gpt-lab-summer-2026/rc-tank/raw.png

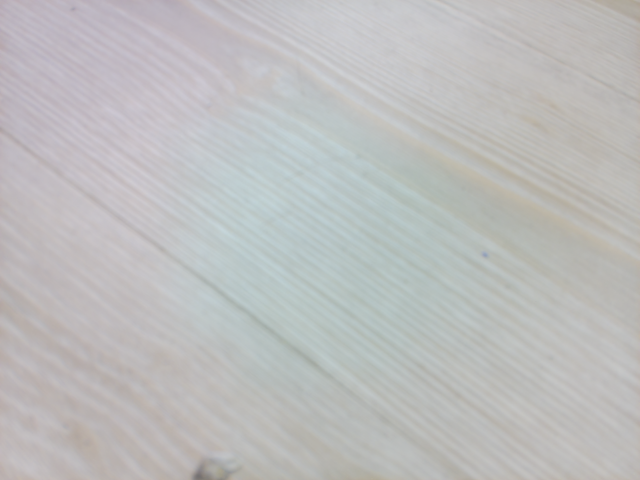
raw.png
