gpt-lab-summer-2026/rc-tank/roam.jpg

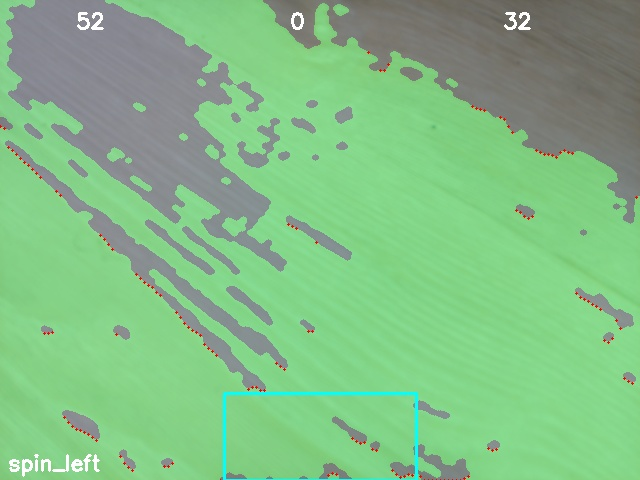
roam.jpg
