gpt-lab-summer-2026/rc-tank/esp32_relay_bridge/esp32_relay_bridge.ino

/* =============================================================
   ESP32 relay bridge — serial in, relays out
   -------------------------------------------------------------
   The Pi decides everything. This firmware holds no idea of what
   forward means, how a turn should look, or how long to hold it.
   It sets relay states and reports back.

   Flash it once. All driving logic lives in Python.

   -------------------------------------------------------------
   WIRING

     ESP32 GPIO 27 -> IN1     motor 1, relay A
     ESP32 GPIO 26 -> IN2     motor 1, relay B
     ESP32 GPIO 25 -> IN3     motor 2, relay A
     ESP32 GPIO 33 -> IN4     motor 2, relay B
     ESP32 GND     -> module GND
     module VCC    -> 5V

     ESP32 GPIO 32 -> buzzer +
     ESP32 GND     -> buzzer -

     ESP32 GPIO 13 -> camera mast servo signal
     servo V+      -> 5V        (see the current note below)
     servo GND     -> common GND

     COM -> its own motor terminal
     NO  -> battery +    (all four)
     NC  -> battery -    (all four)

   -------------------------------------------------------------
   BUZZER — NOT ON GPIO 35

   GPIO 34, 35, 36 and 39 on a classic ESP32 are input-only. They
   have no output driver on the die at all, so pinMode(OUTPUT) is
   ignored and the pin can neither source nor sink current. A buzzer
   wired to one of them is silent no matter what this firmware does,
   and nothing reports an error. GPIO 32 is used instead: free here,
   not a strapping pin, and next to 33 on most dev boards.

   It wants a PASSIVE buzzer — the kind with no oscillator inside.
   Those take a square wave and play whatever pitch you feed them,
   which is what makes three distinct notes possible. An ACTIVE
   buzzer has its own oscillator and one fixed pitch, so the tune
   below degenerates into three beeps of the same note. Still a
   usable startup signal, just not a tune.

   A piezo element can hang straight off the GPIO — it is basically
   a capacitor and draws almost nothing. An electromagnetic buzzer
   cannot: it will pull more than the 20 mA a pin should give, so
   drive it through a small NPN transistor with a flyback diode, and
   take the coil current from 5V rather than 3V3. That rail is
   already the one that browns out under motor inrush.

   On this build motor 1 (IN1/IN2) is the RIGHT track and motor 2
   (IN3/IN4) is the LEFT. The firmware neither knows nor cares —
   car.py hands the sides over to match. See SWAP_SIDES there.

   Pi connects over USB. 115200 baud.

   TWO RULES THAT KEEP A DEAD ESP32 FROM DRIVING THE MOTORS

   1. FIT A 10k PULL-UP FROM EACH OF IN1..IN4 TO 3V3.

      Between the moment this chip resets and the first line of
      setup() below, its pins are floating inputs. On an active-low
      board a floating input can read as "on", holding the relays
      closed while no code is running to release them. Firmware
      cannot close that window — only the pull-ups can.

   2. KEEP THE COILS ON THE SAME 5V AS THIS CHIP.

      Tempting to give the coils their own supply, since their
      switching noise is what sags this one. Do not. Sharing a rail
      means losing it releases the relays: no logic, no coils, motors
      stop. Split the rails and a chip that dies while the coil
      supply lives leaves the relays latched with nothing driving
      them — which is the failure this whole note exists to prevent.

      Fix the noise with capacitance, not with separation.

   Rule 1 covers a reset or a hang, where 3V3 is still up. Rule 2
   covers losing 5V altogether. Both are needed; neither is enough
   on its own.

   -------------------------------------------------------------
   PROTOCOL — one line in, one line out, always

     R a b c d     set relays IN1..IN4, each 0 or 1
     P             ping, changes nothing
     S             all relays off
     ?             report configuration
     C D <ms>      dead-time, 0 disables
     C W <ms>      watchdog, 0 disables
     C A <0|1>     active low (1) or active high (0)
     C S <ms>      stagger between the two motors, 0 disables
     V <angle>     camera mast servo, 0-180. Negative lets it go limp
     T <n>         play tune n (0 teleop, 1 roam, 2 record, 3 mast)

   Replies:

     ok a b c d up=<ms>      the states actually applied right now
     info ... up=<ms>        configuration
     err <reason>

   And two lines that arrive WITHOUT being asked for. They start
   with their own words so the Pi can tell them from a reply:

     boot reason=<why>       printed once, when this chip starts
     evt watchdog-released   printed when the watchdog drops the relays

   The servo is NOT touched by the watchdog. Losing the Pi releases
   the motors because a moving tank with nobody driving is the
   dangerous case; dropping the camera mast is merely untidy, and a
   mast that slammed down every time the link hiccuped would wear out
   faster than it would ever help. It also comes up detached after a
   reset rather than driving to a default, so a brownout does not
   lurch it.

   A servo holding position against gravity draws current the whole
   time it is held, from the same 5V rail the relay coils already sag.
   If boot reason starts coming back BROWNOUT once the mast is up,
   that is the new load, not a new fault: send V -1 to let it go limp
   once the camera is where you want it, or give the servo its own
   supply with a common ground.

   'boot' appearing mid-session means the bridge restarted under
   you. reason=BROWNOUT means the supply sagged, which on this
   hardware means the motors took the rail down. So does up=
   suddenly counting from near zero again.

   The reply to R reports what is APPLIED, which during a
   dead-time pause is not yet what you asked for. Send P a moment
   later to see it land.

   -------------------------------------------------------------
   THE THREE THINGS FIRMWARE STILL DOES

   Dead-time delays a reversal, it never changes one. Asking a
   spinning motor to reverse still reverses it, just deadtime= ms
   later with a stop inserted. The ESP32 does this because it knows
   when the contact settled and the Pi does not.

   It delays NOTHING ELSE. A reversal is the only order that waits:
   a stop, a start, or going back to the direction the motor was
   already turning is applied the moment the line lands, including
   part-way through a pause that some earlier order started. An
   order that arrives mid-pause and is still a reversal keeps
   waiting out the original delay rather than restarting it, so
   hammering the keys cannot stretch a pause indefinitely.

   The practical shape of that, per motor: pause only when the
   contacts are making one way and the new order makes them the
   other way. Once both coils are open, nothing is queued.

   The watchdog acts only when there is NO command. If the USB
   drops or the Pi dies, there is nothing to obey and the relays
   release. It cannot help if this chip is the thing that failed —
   see the pull-up note above.

   Stagger starts the two motors a few milliseconds apart. Both
   starting together draws double the inrush, and inrush is what
   sags a shared rail. Off by default; turn it on with C S 15 if
   boot reason ever comes back BROWNOUT.

   All three are off switches away:  C D 0, C W 0, C S 0.
   With the watchdog off, a crashed Pi leaves the motors running.
   Keep a physical kill switch on the motor battery.
   ============================================================= */

#include <Arduino.h>
#include <esp_system.h>

const int PIN_IN[4] = {27, 26, 25, 33};   // IN1, IN2, IN3, IN4

bool activeLow = true;                    // most 4-relay boards
unsigned long deadtimeMs = 300;
unsigned long watchdogMs = 400;
unsigned long staggerMs = 0;

unsigned long lastRx = 0;
bool watchdogTripped = false;
esp_reset_reason_t bootReason;

// Relays pair up per motor: (IN1,IN2) and (IN3,IN4). This is the
// only topology the firmware knows, and it exists so dead-time
// can tell a reversal from any other state change.
//
// The two delays are kept apart on purpose. They are unrelated —
// one protects the motor, the other protects the supply rail — and
// sharing a single timer between them is what used to make an
// unrelated command wait out a reversal it had nothing to do with.
struct Pair {
  int ia, ib;                 // indices into PIN_IN
  bool apA, apB;              // applied
  bool tgA, tgB;              // target
  unsigned long deadUntil;    // reversal pause expiry
  bool inDead;                // a reversal pause is running
  bool deadFrom;              // apA as it was when that pause began
  unsigned long staggerUntil; // inrush delay expiry
};

Pair pairs[2] = {
  {0, 1, false, false, false, false, 0, false, false, 0},
  {2, 3, false, false, false, false, 0, false, false, 0},
};

// One note of the startup tune. The buzzer code is all further down,
// but this type has to be declared up here, above the first function
// definition in the file.
//
// The Arduino IDE generates a prototype for every function and injects
// them all immediately before the first function definition. That is
// several hundred lines above the buzzer section, so a Note declared
// down there does not exist yet when the generated
// "void playTune(const Note *, int);" is compiled, and the build fails
// with 'Note' does not name a type. Pair above is fine for exactly the
// same reason in reverse: it is already declared before that point.
struct Note { unsigned int hz, ms; };

// ---------------------------- relays ----------------------------

// Every actuation is counted. Contacts are a consumable — they weld
// eventually, and a welded contact keeps driving a motor after the
// coil has let go. Knowing how many operations each one has done is
// the only warning you get, since nothing here can sense a weld.
bool coilState[4] = {false, false, false, false};
unsigned long relayOps[4] = {0, 0, 0, 0};

inline void coil(int idx, bool on) {
  if (coilState[idx] != on) relayOps[idx]++;
  coilState[idx] = on;
  digitalWrite(PIN_IN[idx], on == activeLow ? LOW : HIGH);
}

void push(Pair &p) {
  coil(p.ia, p.apA);
  coil(p.ib, p.apB);
}

void pushAll() {
  push(pairs[0]);
  push(pairs[1]);
}

// Walks applied towards target. A direction flip goes through
// both-off first and waits out the dead-time. Everything else is
// applied the moment it arrives.
void tick(Pair &p) {
  if (p.tgA == p.apA && p.tgB == p.apB) {
    // Nothing outstanding. If a reversal pause was running, the move
    // it was holding back has since been withdrawn — a stop, usually
    // — so drop the pause rather than leave it timing out against an
    // order nobody is waiting for any more.
    p.inDead = false;
    return;
  }

  unsigned long now = millis();
  bool driving   = p.apA != p.apB;     // contacts are making, one way
  bool wantDrive = p.tgA != p.tgB;     // asked to keep making, either way

  // Stagger spreads inrush, so it only has anything to say about
  // orders that draw current. A stop is let straight through.
  if (wantDrive && now < p.staggerUntil) return;

  // The one change worth delaying: both coils open, then the other
  // way round once the armature has had a moment to stop pushing
  // back against it.
  if (deadtimeMs > 0 && driving && wantDrive && p.apA != p.tgA) {
    p.deadFrom = p.apA;
    p.inDead = true;
    p.deadUntil = now + deadtimeMs;
    p.apA = false;
    p.apB = false;
    push(p);
    return;
  }

  // Mid-pause. Keep waiting only while the standing order still
  // points the other way. Asking for the direction it was already
  // turning, or for a stop, is not a reversal and must not sit out
  // the rest of a delay that was protecting against a different move
  // entirely — waiting there is what made the controls feel
  // rate-limited, and it protected nothing, because the motor is
  // already stopped and the request is not a reversal.
  // deadtimeMs is re-read here rather than trusted from pause entry,
  // so C D 0 releases a pause already running instead of leaving one
  // last delay to time out after the feature was switched off.
  if (deadtimeMs > 0 && p.inDead && now < p.deadUntil &&
      wantDrive && p.tgA != p.deadFrom) return;

  p.inDead = false;
  p.apA = p.tgA;
  p.apB = p.tgB;
  push(p);
}

void targetsOff() {
  for (int i = 0; i < 2; i++) {
    pairs[i].tgA = false;
    pairs[i].tgB = false;
  }
}

// The servo lives up here, above replyInfo() and handleLine(), because
// both read servoAngle. The Arduino IDE hoists prototypes for
// FUNCTIONS but not for variables, so a servoAngle declared further
// down compiles as 'not declared in this scope' — the same trap that
// put struct Note up with struct Pair.
// ---------------------------- servo -----------------------------

// Camera mast. 0 lowers it, 125 lifts it; the rest of the 0-180 range
// is reachable but nothing here asks for it.
const int PIN_SERVO   = 13;
const int SERVO_CH    = 6;                // its own LEDC timer, not the buzzer's
const int SERVO_MIN_US = 500;             // 0 degrees
const int SERVO_MAX_US = 2400;            // 180 degrees

// -1 means detached: no pulse train, so the horn is limp and drawing
// nothing. That is the state at power-on, deliberately. Driving the
// mast somewhere at boot would lurch it on every brownout reset, and
// a servo told to hold a position holds it by pulling current from
// the same 5V rail these relays already sag — see the wiring notes.
int servoAngle = -1;

#if defined(ESP_ARDUINO_VERSION_MAJOR) && ESP_ARDUINO_VERSION_MAJOR >= 3
  #define SERVO_ATTACH()  ledcAttach(PIN_SERVO, 50, 16)
  #define SERVO_DUTY(d)   ledcWrite(PIN_SERVO, (d))
  #define SERVO_DETACH()  ledcDetach(PIN_SERVO)
#else
  #define SERVO_ATTACH()  (ledcSetup(SERVO_CH, 50, 16), \
                           ledcAttachPin(PIN_SERVO, SERVO_CH))
  #define SERVO_DUTY(d)   ledcWrite(SERVO_CH, (d))
  #define SERVO_DETACH()  ledcDetachPin(PIN_SERVO)
#endif

// Angle in, or negative to let go. 50 Hz means a 20000 us frame, so
// the duty for a pulse is simply its share of that frame.
void servoWrite(int angle) {
  if (angle < 0) {
    if (servoAngle >= 0) {
      SERVO_DETACH();
      // Detaching stops LEDC driving the pin but leaves it wherever
      // the peripheral let go. A servo signal line that floats picks
      // up whatever is on the harness and can twitch on it, so park it
      // definitively low: no edges, no pulses, nothing to decode.
      pinMode(PIN_SERVO, OUTPUT);
      digitalWrite(PIN_SERVO, LOW);
    }
    servoAngle = -1;
    return;
  }
  if (angle > 180) angle = 180;
  if (servoAngle < 0) SERVO_ATTACH();

  unsigned long us = SERVO_MIN_US +
                     (unsigned long)(SERVO_MAX_US - SERVO_MIN_US) * angle / 180;
  SERVO_DUTY((us * 65536UL) / 20000UL);
  servoAngle = angle;
}

// ---------------------------- buzzer ----------------------------

// See the BUZZER note in the header before moving this to 34/35/36/39.
const int PIN_BUZZER = 32;
const int BUZZER_CH  = 4;                 // LEDC channel, nothing else uses it

// struct Note is declared up with struct Pair, not here. See the note
// there for why moving it back down breaks the build.

// The LEDC API was rewritten in Arduino-ESP32 3.0: channels became
// implicit and the calls take the pin. Both spellings are kept so
// this compiles whichever core is installed.
#if defined(ESP_ARDUINO_VERSION_MAJOR) && ESP_ARDUINO_VERSION_MAJOR >= 3
  #define BUZZER_BEGIN()  ledcAttach(PIN_BUZZER, 2000, 10)
  #define BUZZER_TONE(f)  ledcWriteTone(PIN_BUZZER, (f))
#else
  #define BUZZER_BEGIN()  (ledcSetup(BUZZER_CH, 2000, 10), \
                           ledcAttachPin(PIN_BUZZER, BUZZER_CH))
  #define BUZZER_TONE(f)  ledcWriteTone(BUZZER_CH, (f))
#endif

// Rising: the bridge came up when you asked it to.
const Note STARTUP[] = {{784, 90}, {988, 90}, {220, 160}};   // G5 B5 E6

// Falling: it came up when you  did NOT ask it to. Same three notes
// backwards, which is enough to tell apart from across a room.
//
// This is the cheap half of a diagnostic the firmware already cares
// about — a restart mid-drive means the motors took the rail down,
// and until now the only way to notice was watching the terminal.
// Delete RESTART and the branch in setup() if you would rather every
// boot sounded the same.
const Note RESTART[] = {{1319, 90}, {988, 90}, {784, 160}};

#define TUNE(t) playTune((t), sizeof(t) / sizeof((t)[0]))

void playTune(const Note *notes, int count) {
  for (int i = 0; i < count; i++) {
    BUZZER_TONE(notes[i].hz);
    delay(notes[i].ms);
  }
  BUZZER_TONE(0);                         // do not leave the pin driven
}

// The restarts that are routine. Opening the serial port resets the
// board, so these three are expected at the start of every run —
// car.py's _NORMAL_BOOT holds the same list for the same reason.
bool bootExpected(esp_reset_reason_t r) {
  return r == ESP_RST_POWERON || r == ESP_RST_EXT || r == ESP_RST_SW;
}

// One short major-key run per program, played when that program
// connects. Different enough to tell apart from the next room, which
// is the point: you learn which thing started without looking at the
// terminal, and a tune you did not expect means something restarted.
//
// All under 400 ms. This plays while the tank is live, and every note
// is time the operator spends waiting to drive.
const Note TUNE_TELEOP[] = {{523, 90}, {659, 90}, {784, 150}};
const Note TUNE_ROAM[]   = {{659, 80}, {784, 80}, {988, 80}, {1319, 160}};
const Note TUNE_RECORD[] = {{784, 90}, {1047, 90}, {784, 90}, {1319, 160}};

// Goofy on purpose, and short on purpose: this one plays every single
// time the mast goes up, so it has to stay funny at the fiftieth
// hearing rather than the first. A rising slide that trips over
// itself twice on the way — it reads as the camera scrambling to its
// feet, and at 320 ms it is done before the servo has finished.
const Note TUNE_MAST[] = {
  {659, 45}, {988, 45}, {784, 45}, {1319, 45}, {1047, 45}, {1568, 95},
};

struct Tune { const Note *notes; int count; };
const Tune TUNES[] = {
  {TUNE_TELEOP, 3},
  {TUNE_ROAM,   4},
  {TUNE_RECORD, 4},
  {TUNE_MAST,   6},
};
const int TUNE_COUNT = sizeof(TUNES) / sizeof(TUNES[0]);

// Non-blocking, unlike playTune above, and for a specific reason.
// The boot tune can afford to block: nothing is driving yet. A tune
// asked for over the wire cannot, because blocking loop() would stop
// tick() servicing a dead-time pause and stop the watchdog noticing a
// dead Pi. A buzzer should not be able to do either of those, so this
// one is a state machine that loop() steps through.
const Note *tuneNotes = nullptr;
int tuneCount = 0, tuneAt = 0;
unsigned long tuneUntil = 0;

void startTune(const Note *notes, int count) {
  tuneNotes = notes;
  tuneCount = count;
  tuneAt = -1;                    // first service() advances to note 0
  tuneUntil = 0;
}

void serviceTune() {
  if (tuneNotes == nullptr) return;

  unsigned long now = millis();
  if (tuneAt >= 0 && now < tuneUntil) return;

  tuneAt++;
  if (tuneAt >= tuneCount) {
    BUZZER_TONE(0);               // do not leave the pin driven
    tuneNotes = nullptr;
    return;
  }
  BUZZER_TONE(tuneNotes[tuneAt].hz);
  tuneUntil = now + tuneNotes[tuneAt].ms;
}

// ---------------------------- replies ----------------------------

const char *resetReasonName(esp_reset_reason_t r) {
  switch (r) {
    case ESP_RST_POWERON:   return "power-on";
    case ESP_RST_EXT:       return "external-pin";
    case ESP_RST_SW:        return "software";
    case ESP_RST_PANIC:     return "PANIC";
    case ESP_RST_INT_WDT:   return "INT-WATCHDOG";
    case ESP_RST_TASK_WDT:  return "TASK-WATCHDOG";
    case ESP_RST_WDT:       return "WATCHDOG";
    case ESP_RST_DEEPSLEEP: return "deep-sleep-wake";
    case ESP_RST_BROWNOUT:  return "BROWNOUT";
    case ESP_RST_SDIO:      return "sdio";
    default:                return "unknown";
  }
}

void replyOk() {
  bool s[4];
  s[pairs[0].ia] = pairs[0].apA;
  s[pairs[0].ib] = pairs[0].apB;
  s[pairs[1].ia] = pairs[1].apA;
  s[pairs[1].ib] = pairs[1].apB;
  Serial.printf("ok %d %d %d %d up=%lu\n", s[0], s[1], s[2], s[3], millis());
}

void replyInfo() {
  Serial.printf(
    "info bridge=1 deadtime=%lu watchdog=%lu activelow=%d stagger=%lu "
    "servo=%d boot=%s up=%lu ops=%lu,%lu,%lu,%lu\n",
    deadtimeMs, watchdogMs, activeLow ? 1 : 0, staggerMs, servoAngle,
    resetReasonName(bootReason), millis(),
    relayOps[0], relayOps[1], relayOps[2], relayOps[3]);
}

// ---------------------------- parsing ----------------------------

void handleLine(char *line) {
  lastRx = millis();
  watchdogTripped = false;

  switch (line[0]) {
    case 'R': case 'r': {
      int a, b, c, d;
      if (sscanf(line + 1, "%d %d %d %d", &a, &b, &c, &d) != 4) {
        Serial.println("err bad-args");
        return;
      }
      if ((a | b | c | d) & ~1) {         // anything other than 0 or 1
        Serial.println("err not-binary");
        return;
      }

      // Does each motor actually change? Asked before the targets
      // move, because that is what decides whether staggering them
      // buys anything.
      bool moves0 = (pairs[0].apA != (bool)a) || (pairs[0].apB != (bool)b);
      bool moves1 = (pairs[1].apA != (bool)c) || (pairs[1].apB != (bool)d);

      pairs[0].tgA = a; pairs[0].tgB = b;
      pairs[1].tgA = c; pairs[1].tgB = d;

      if (staggerMs > 0 && moves0 && moves1) {
        unsigned long due = millis() + staggerMs;
        if (pairs[1].staggerUntil < due) pairs[1].staggerUntil = due;
      }

      tick(pairs[0]);                     // apply now if nothing pending
      tick(pairs[1]);
      replyOk();
      return;
    }

    case 'V': case 'v': {
      int a;
      if (sscanf(line + 1, "%d", &a) != 1) {
        Serial.println("err bad-args");
        return;
      }
      servoWrite(a);
      Serial.printf("ok servo=%d up=%lu\n", servoAngle, millis());
      return;
    }

    case 'T': case 't': {
      int n;
      if (sscanf(line + 1, "%d", &n) != 1) {
        Serial.println("err bad-args");
        return;
      }
      if (n < 0 || n >= TUNE_COUNT) {
        Serial.println("err bad-tune");
        return;
      }
      startTune(TUNES[n].notes, TUNES[n].count);
      Serial.printf("ok tune=%d up=%lu\n", n, millis());
      return;
    }

    case 'P': case 'p':
      replyOk();
      return;

    case 'S': case 's':
      targetsOff();
      tick(pairs[0]);
      tick(pairs[1]);
      replyOk();
      return;

    case '?':
      replyInfo();
      return;

    case 'C': case 'c': {
      char which;
      int val;
      if (sscanf(line + 1, " %c %d", &which, &val) != 2) {
        Serial.println("err bad-args");
        return;
      }
      if (val < 0) val = 0;
      switch (toupper(which)) {
        case 'D': deadtimeMs = val; break;
        case 'W': watchdogMs = val; break;
        case 'S': staggerMs  = val; break;
        case 'A': activeLow = (val != 0); pushAll(); break;
        default:  Serial.println("err bad-key"); return;
      }
      replyInfo();
      return;
    }

    default:
      Serial.println("err bad-command");
  }
}

char buf[48];
int  blen = 0;

void readSerial() {
  while (Serial.available()) {
    char c = Serial.read();

    if (c == '\n' || c == '\r') {
      if (blen == 0) continue;            // ignore blank lines
      buf[blen] = '\0';
      handleLine(buf);
      blen = 0;
    } else if (blen < (int)sizeof(buf) - 1) {
      buf[blen++] = c;
    } else {
      blen = 0;                           // overlong, drop it
      Serial.println("err too-long");
    }
  }
}

// ----------------------------- main -----------------------------

void setup() {
  // Pins first, ahead of everything including Serial. Every
  // millisecond spent before this line is a millisecond the relays
  // are answering to a floating input rather than to us.
  //
  // Latch the level BEFORE switching the pin to an output: a fresh
  // output starts low, and low is exactly what an active-low board
  // reads as "on". Writing first means it comes up already released.
  for (int i = 0; i < 4; i++) {
    coil(i, false);
    pinMode(PIN_IN[i], OUTPUT);
    coil(i, false);
  }

  bootReason = esp_reset_reason();

  Serial.begin(115200);
  delay(200);
  Serial.println();
  Serial.printf("boot reason=%s\n", resetReasonName(bootReason));

  // Blocking is fine here and nowhere else. The coils were released
  // at the top of this function, the watchdog is not running yet, and
  // nothing can send a command until loop() starts reading — so the
  // ~340 ms this takes costs nothing that matters. It runs before
  // lastRx is set, so the watchdog still starts from a standing start
  // rather than immediately owing 340 ms.
  BUZZER_BEGIN();
  if (bootExpected(bootReason)) TUNE(STARTUP);
  else                          TUNE(RESTART);

  lastRx = millis();
}

void loop() {
  readSerial();

  // Nothing heard for too long means there is no command to obey.
  // Say so once, rather than every pass — silence here has been
  // mistaken for the watchdog working before now.
  if (watchdogMs > 0 && millis() - lastRx > watchdogMs) {
    if (!watchdogTripped) {
      watchdogTripped = true;
      Serial.println("evt watchdog-released");
    }
    targetsOff();
  }

  serviceTune();

  tick(pairs[0]);
  tick(pairs[1]);
}
