gpt-lab-summer-2026/rc-tank/teleop.py

#!/usr/bin/env python3
"""
Phase 0 — drive the car from the keyboard.

Proves the serial link, the protocol, the dead-time and the
watchdog all work before any camera or model is involved.

    python3 teleop.py
    python3 teleop.py --port /dev/ttyUSB0
    python3 teleop.py --selftest        click each relay (motors off!)

Keep car.py in the same directory.

A terminal cannot see key releases, so commands latch: press a key
and the car keeps doing that until you press another one or space.
"""

from __future__ import annotations

import argparse
import os
import select
import sys
import termios
import time
import tty

from car import Car, BridgeError, boot_warning

# key -> (label, (left, right)).  Latching states.
KEYS = {
    "w": ("forward",   (1, 1)),
    "s": ("backward",  (-1, -1)),
    "q": ("arc left",  (0, 1)),
    "e": ("arc right", (1, 0)),
    " ": ("stop",      (0, 0)),
}

# key -> side.  Timed nudges, not states — see Car.soft_arc.
ARCS = {"a": "left", "d": "right"}

# The same nudge with both tracks backing instead of driving. There is
# no held reverse arc to pair with q/e, because idling one track while
# the other backs digs this chassis in rather than turning it. The
# pulse works where the hold does not: both tracks are already moving,
# so the interruption swings the nose instead of stalling it.
BACK_ARCS = {"z": "left", "c": "right"}

# Everything roam sees, driven by hand instead of by a policy. Loaded
# lazily in main() so teleop still starts on a machine with no OpenCV
# and no camera — driving the tank must not depend on being able to
# look at it.

# Camera mast. t and g are the two presets; the nudges exist so the
# raised angle can be dialled in against the real linkage without
# editing car.py and restarting, which is otherwise a reflash-speed
# loop for a one-number question.
#
# v lets the servo go limp. That is the thing to reach for if holding
# the mast up is what starts browning out the 5V rail — a servo under
# load draws current for as long as it is asked to hold.
MAST_STEP = 5
MAST = {
    # t and g nudge, they are not presets. Aiming the camera is a
    # thing you do by eye against the live view, a few degrees at a
    # time, so the keys that do it most often get the easy position.
    "t": MAST_STEP,  "+": MAST_STEP,  "=": MAST_STEP,
    "g": -MAST_STEP, "-": -MAST_STEP, "_": -MAST_STEP,
    "b": "up",        # back to the driving angle, in one press
    "v": "limp",
}


def mast_key(car: Car, action) -> str:
    """Apply one mast keypress and describe where the mast ended up."""
    if action == "up":
        # settle=0 because the operator is watching it move and does
        # not need the key loop to go deaf for most of a second.
        car.camera_up(settle=0.0)
    elif action == "limp":
        car.mast(-1)
    else:
        car.mast_nudge(action)

    angle = car.mast_angle
    if angle is None or angle < 0:
        return "mast limp (drawing nothing)"
    if angle in (Car.MAST_UP, Car.MAST_DOWN):
        return f"mast {angle} deg"
    # Off-preset means it is being calibrated, so say what to keep.
    return f"mast {angle} deg   (Car.MAST_UP is {Car.MAST_UP})"

HELP = """
  w  forward        s  backward

  q  arc left       e  arc right      latched — stays until cancelled
  a  arc left       d  arc right      hold the key, release to stop
  z  back arc left  c  back arc right same, both tracks reversing

  space  stop       x  quit
  r      unstick    i  show config and relay operation counts

  t  camera up       g  camera down     5 deg a press
  b  back to the driving angle            v  mast limp

  l  look around: stop, raise the mast, say what the model sees
     (needs --detect; --stream serves the same view roam would use)

Both arcs steer the same way — the inside track idles and the outside
one pulls the nose round. They differ only in who ends them.

  q / e   latch. The tank keeps turning until you press w, space, or
          something else. Use them to come round a long way.

  a / d   follow the key. Hold to keep turning; let go and the tracks
          go straight back to what they were doing. Steer with these.
          z / c are the same, backing up.

Holding works by watching the terminal's key repeat, because a
terminal cannot see a key being released — only that the same
character has stopped arriving. So the turn runs on very briefly
after you let go (--arc-release), and the first press is given longer
(--arc-hold) to cover the pause before repeat starts. If a held arc
stutters, raise --arc-hold; if it overshoots on release, lower
--arc-release.

There is no spin. Opposing the tracks reverses a motor under load,
which is the harshest thing this drivetrain does to its contacts, and
an arc reaches the same heading without it.

Reversals wait --reverse-cooldown before they are allowed again;
arcs, stops and starts wait only --cooldown, nothing by default. A
press inside a window shows HELD. Space is never held.

r drives backwards briefly, then stops. That clears a relay that has
stayed engaged. Expect the rover to move.

relays[...] is what the bridge reports as APPLIED. Pressing space
should show relays[0 0 0 0]. If it does and the tracks keep turning,
try r. If that does not free it either, cut the motor power.
"""


def read_keys(timeout: float = 0.1) -> str:
    """Every key pressed since the last call, in order.

    Reads the file descriptor rather than sys.stdin, because the two
    do not agree with select(). sys.stdin.read(1) pulls the whole
    pending chunk out of the OS and hands back one character, leaving
    the rest in a buffer select() cannot see — so the next select()
    reports nothing waiting and those keys sit unnoticed until
    another one arrives.

    It bites hardest exactly when it matters: if the bridge is slow,
    every command blocks for the read timeout, keystrokes pile up
    behind it, and the one that goes missing is the stop you just
    pressed twice.
    """
    ready, _, _ = select.select([sys.stdin], [], [], timeout)
    if not ready:
        return ""
    return os.read(sys.stdin.fileno(), 64).decode(errors="replace")


def relay_ops(info_line: str) -> list[int]:
    """Per-relay actuation counts out of an info reply."""
    for field in info_line.split():
        if field.startswith("ops="):
            try:
                return [int(x) for x in field[4:].split(",")]
            except ValueError:
                break
    return []


def selftest(car: Car) -> int:
    """Click each relay on its own, with a human as the sensor.

    Nothing reports back from the contacts, so the firmware cannot
    tell a relay that opened from one that welded shut. It can only
    energise them one at a time and leave you to listen. Four relays,
    four clicks, four releases. A relay that stays silent is stuck,
    and a stuck relay is what keeps a tank driving after it has been
    told to stop.
    """
    print("\n  DISCONNECT THE MOTOR BATTERY FIRST.")
    print("  This energises relays on purpose. With motors attached,")
    print("  the tank will move.\n")
    try:
        input("  Motors disconnected? Enter to run, ctrl-c to abort. ")
    except (KeyboardInterrupt, EOFError):
        print("\n  aborted")
        return 1

    before = relay_ops(car.info())
    print()

    for i in range(4):
        state = [0, 0, 0, 0]
        state[i] = 1
        print(f"  relay {i + 1} (IN{i + 1})   energise ...", end="", flush=True)
        car.relays(*state)
        time.sleep(0.6)
        print(" release ...", end="", flush=True)
        car.relays(0, 0, 0, 0)
        time.sleep(0.5)
        print(" done")

    after = relay_ops(car.info())
    print()
    if before and after and len(before) == len(after) == 4:
        print("  lifetime operations, per relay:")
        for i, (b, a) in enumerate(zip(before, after)):
            print(f"    IN{i + 1}  {a:6d}   (+{a - b} this test)")
        print()
        print("  Contacts are a consumable. Log these each session — welding")
        print("  gets likelier as they climb, and nothing warns you first.")
        print()

    print("  You should have heard EIGHT clicks: four energise, four release.")
    print("  A relay that never clicked, or clicked once and not again, is")
    print("  stuck. With the motor battery still disconnected, meter COM to")
    print("  NO on that relay — it must read open. Continuity means welded.")
    return 0


def main() -> int:
    ap = argparse.ArgumentParser()
    ap.add_argument("--port", default=None, help="serial device")
    ap.add_argument("--selftest", action="store_true",
                    help="click each relay in turn, then stop (motors off!)")
    ap.add_argument("--reverse-cooldown", type=float, default=0.5,
                    help="seconds before a motor may be reversed again; the "
                         "one change that fights the motor's own momentum")
    ap.add_argument("--cooldown", type=float, default=0.0,
                    help="seconds before any gentler change — arc, stop, "
                         "start — is allowed")
    ap.add_argument("--arc-hold", type=float, default=0.7,
                    help="how long the FIRST arc keypress lasts. Must outlast "
                         "the terminal's delay before auto-repeat starts, or a "
                         "held arc stutters")
    ap.add_argument("--arc-release", type=float, default=0.25,
                    help="how long an arc runs on after the last repeat. Lower "
                         "feels snappier on release; too low and it stutters")
    ap.add_argument("--unstick-time", type=float, default=0.5,
                    help="seconds to drive backwards when r is pressed")
    ap.add_argument("--no-servo", action="store_true",
                    help="do not raise the camera mast")
    from roam import add_lowbattery_args
    add_lowbattery_args(ap)
    # The same flags roam uses, from the same definitions, so a value
    # tuned while driving by hand means the same thing when roam runs.
    from roam import add_perception_args, add_detect_args, add_view_args
    add_perception_args(ap)
    add_detect_args(ap)
    add_view_args(ap)
    args = ap.parse_args()

    try:
        car = Car(port=args.port,
                  command_cooldown=args.cooldown,
                  reverse_cooldown=args.reverse_cooldown)
    except BridgeError as e:
        print(f"could not open the bridge: {e}", file=sys.stderr)
        return 1

    print(f"connected on {car.port}")
    print(car.info())

    car.chirp(Car.TUNE_TELEOP)

    warning = boot_warning(car.boot_reason)
    if warning:
        print(f"\n  !! {warning}\n")

    if args.selftest:
        try:
            return selftest(car)
        finally:
            car.close()

    print(HELP)

    # Perception is optional. Without --stream or --detect this is the
    # same keyboard driver it always was, and nothing imports OpenCV.
    cam = floor = view = detector = reporter = perceive = None
    marks = []
    shown_dets, shown_at, last_detect = [], 0.0, 0.0

    if args.stream or args.detect:
        try:
            from record import Camera
            from roam import FloorModel, perceive, annotate
            from stream import MJPEGStreamer

            cam = Camera(lock_exposure=not args.no_lock_exposure,
                         rotate=args.rotate,
                         mast=None if args.no_servo else car)
            print("\nlearning the floor — keep a metre of clear ground ahead")
            time.sleep(1.0)
            floor = FloorModel(smooth=args.adapt, mode=args.channels,
                               bins=args.bins, flatten=args.flatten)
            from roam import shrink
            floor.learn(shrink(cam.frame(), args.scale))
            print(f"learned: {getattr(floor, 'why', floor.chosen)}")

            from roam import marks_for
            marks = marks_for(args, shrink(cam.frame(), args.scale).shape[0])

            if args.stream:
                view = MJPEGStreamer(port=args.stream)
                print(f"live view on http://<this-pi>:{view.port}/  "
                      f"(or tunnel: ssh -N -L {view.port}:localhost:{view.port} ...)")
            if args.detect:
                from detect import Detector, Reporter
                detector = Detector(args.detect, conf=args.detect_conf,
                                    threads=args.detect_threads)
                reporter = Reporter(cooldown=args.report_cooldown)
                print(f"detector {args.detect} at {detector.size}x{detector.size}")
        except Exception as e:
            print(f"  !! no camera view: {e}", file=sys.stderr)
            cam = floor = None

    def say(line: str) -> None:
        print("\r" + " " * 78 + "\r" + line, flush=True)

    fd = sys.stdin.fileno()
    saved = termios.tcgetattr(fd)
    quitting = False

    # Hold-to-arc, inferred from auto-repeat.
    #
    # A terminal never reports a key release, so there is nothing to
    # wait for. What it does report, while a key is down, is the same
    # character over and over — so "still held" becomes "repeats are
    # still arriving", and the arc ends when they stop.
    #
    # The two graces exist because the gaps are not equal. Terminals
    # pause noticeably before the first repeat and then fire quickly,
    # so one timeout either stutters at the start or hangs on after
    # release. The first press gets the long allowance and every
    # repeat after it the short one.
    current = (0, 0)          # last latched command, restored after an arc
    arc_until = None          # when the arc lapses, if one is running
    arc_key = None            # which key is holding it
    arc_seen_repeat = False

    try:
        tty.setcbreak(fd)
        while not quitting:
            keys = read_keys().lower()

            # One perception pass per tick, using roam's own code path
            # so what is drawn here is what roam would decide from —
            # not a lookalike that drifts the first time either moves.
            if cam is not None and floor is not None:
                now = time.monotonic()
                try:
                    from roam import blocking_boxes
                    blocks = (blocking_boxes(shown_dets, now - shown_at, args)
                              if detector is not None else [])
                    frame, mask, prof, regs = perceive(cam.frame(), floor, args,
                                                       blocks)
                except Exception:
                    frame = None
                if frame is not None:
                    if detector is not None:
                        if now - last_detect > args.detect_every:
                            last_detect = now
                            detector.submit(frame, "floor")
                        for found in detector.poll():
                            fl = [d for d in found if d.context == "floor"]
                            shown_dets, shown_at = fl, now
                            small = [d for d in fl
                                     if d.area_frac <= args.small_object]
                            for d in reporter.fresh(small, now):
                                say(f"  saw {d.label} ({d.confidence:.0%}) "
                                    f"on the floor  [{detector.last_ms:.0f} ms]")
                        if shown_dets and now - shown_at > max(2.0, args.detect_every * 2):
                            shown_dets = []
                    if view is not None:
                        L, C, R = regs
                        view.update(annotate(frame, mask, prof, regs,
                                             f"L{L:.0f} C{C:.0f} R{R:.0f}",
                                             marks, dets=shown_dets,
                                             small_max=args.small_object,
                                             det_age=now - shown_at,
                                             blocking=blocks))

            for key in keys:
                if key == "x":
                    quitting = True
                    break
                if key == "i":
                    print("\r" + car.info())
                    continue
                if key == "r":
                    print("\runsticking — reversing briefly ...", end="")
                    sys.stdout.flush()
                    try:
                        car.unstick(args.unstick_time)
                        print(" done, stopped        ")
                    except BridgeError as e:
                        print(f"\rerror: {e}")
                    continue
                if key in ARCS or key in BACK_ARCS:
                    back = key in BACK_ARCS
                    side = BACK_ARCS[key] if back else ARCS[key]

                    if arc_key != key:
                        # A fresh arc, or a switch of side mid-hold.
                        # Idle the track that must travel less: going
                        # forward that is the inside one, backing it is
                        # the other, because the nose swings the other
                        # way when the tracks pull the other way.
                        base = -1 if back else 1
                        lr = ((base, 0) if (side == "right") != back
                              else (0, base))
                        try:
                            car.drive(*lr)
                        except BridgeError as e:
                            print(f"\rerror: {e}")
                            continue
                        if car.last_command_held:
                            print(f"\rHELD {car.cooldown_remaining():.1f}s"
                                  f"{'':<28}", end="")
                            sys.stdout.flush()
                            continue
                        arc_key = key
                        arc_seen_repeat = False
                        what = "back arc" if back else "arc"
                        print(f"\r{what} {side:<6} held{'':<24}", end="")
                        sys.stdout.flush()
                    else:
                        arc_seen_repeat = True

                    arc_until = time.monotonic() + (
                        args.arc_release if arc_seen_repeat else args.arc_hold)
                    continue
                if key == "l":
                    if detector is None or cam is None:
                        say("  look around needs --detect")
                        continue
                    say("  looking around ...")
                    try:
                        car.stop()
                        time.sleep(0.4)
                        car.camera_survey()
                        from roam import shrink as _shrink
                        found = detector.run_sync(_shrink(cam.frame(), args.scale),
                                                  "survey")
                        for d in reporter.fresh(found, time.monotonic()):
                            say(f"  room: {d.label} ({d.confidence:.0%})")
                        say(f"  done, {len(found)} object(s), "
                            f"{detector.last_ms:.0f} ms")
                    except Exception as e:
                        say(f"  look around failed: {e}")
                    finally:
                        car.mast_hold(Car.MAST_UP)
                    continue

                if key in MAST:
                    try:
                        print(f"\r{mast_key(car, MAST[key]):<44}", end="")
                        sys.stdout.flush()
                    except BridgeError as e:
                        print(f"\rerror: {e}")
                    continue

                if key not in KEYS:
                    continue

                # A latched order outranks a held arc. Cancel rather
                # than let the arc lapse afterwards and overwrite it.
                arc_until = arc_key = None

                label, (left, right) = KEYS[key]
                current = (left, right)
                try:
                    reply = car.drive(left, right)
                except BridgeError as e:
                    print(f"\rerror: {e}")
                    continue

                # Show what the bridge says is APPLIED, not what was
                # asked for. If this reads 0 0 0 0 while the tracks are
                # still turning, the firmware did as it was told and the
                # fault is a contact that will not open.
                applied = " ".join(reply.split()[1:5])

                if car.last_command_held:
                    # Say why nothing happened. A key that appears to do
                    # nothing is indistinguishable from a broken one.
                    status = f"HELD {car.cooldown_remaining():.1f}s   "
                else:
                    status = f"{label:<12} left={left:+d} right={right:+d}"

                # \r and padding keep the status on one line in cbreak mode
                print(f"\r{status}  relays[{applied}]      ", end="")
                sys.stdout.flush()

            # Outside the key loop on purpose: the arc ends when keys
            # STOP arriving, so this has to run on the passes where
            # nothing was pressed. read_keys blocks for its timeout,
            # which is what paces it.
            if arc_until is not None and time.monotonic() >= arc_until:
                arc_until = arc_key = None
                try:
                    # Forced: the arc started this cooldown itself, and
                    # holding the release would leave a track idling
                    # that the operator has already let go of.
                    reply = car.drive(*current, force=True)
                    applied = " ".join(reply.split()[1:5])
                    print(f"\rreleased      left={current[0]:+d} "
                          f"right={current[1]:+d}  relays[{applied}]      ",
                          end="")
                    sys.stdout.flush()
                except BridgeError as e:
                    print(f"\rerror: {e}")

    except KeyboardInterrupt:
        pass
    finally:
        termios.tcsetattr(fd, termios.TCSADRAIN, saved)
        if detector is not None:
            detector.close()
        if view is not None:
            view.close()
        if cam is not None:
            cam.close()          # lowers the mast, so before the bridge closes
        resets = car.resets
        car.close()
        print("\nstopped, port closed")
        if resets:
            print(f"\n!! the bridge restarted {resets} time(s) during that session.")
            print("   Each restart is a window where the relays answered to")
            print("   nothing. Check the boot reason above and the 5V supply.")

    return 0


if __name__ == "__main__":
    sys.exit(main())
