gpt-lab-summer-2026/rc-tank/(commit log)

2026-08-04 Working motor tests
2026-08-11 Fixes for stuck motors
    [car.py, esp32_relay_bridge.ino, record.py, roam.py, teleop.py]
2026-08-13 fixed upside down bug and histogram errors
    [esp32_relay_bridge.ino, esp32_remote_dac.ino, esp32_remote_sim.ino, record.py, roam.py]
2026-08-14 new software for debugging stupid camera issue
    [floorcheck.py]
2026-08-14 fixed channel compensation of image processing
    [esp32_relay_bridge.ino, floorcheck.py, roam.py]
2026-08-14 added servo for camera
2026-08-14 fixed camera exit
2026-08-14 adjusted servo angle
2026-08-14 added camera mast control
2026-08-17 edited reversing protocol on obstacle avoidance, added buzzer startup sounds to all scripts. W
    [car.py, esp32_relay_bridge.ino, record.py, roam.py, teleop.py]
2026-08-17 added new control protocols and failsafes to low power issues
    [car.py, esp32_relay_bridge.ino, teleop.py]
2026-08-19 added deteciton titles to debug image, inverted survey angle
    [car.py, roam.py]
2026-08-20 fixed horizon issues and newest config
    [roam.py]
2026-08-25 added manual camera driving properties
2026-08-26 added low battery driving protocols
